abhay2004-rgb/class-D-3255/README.md

# class-D-3255
High-performance Class-D audio amplifier project based on the TPA3255 IC, designed for efficient power amplification, high-quality sound reproduction, and low distortion. This project explores audio electronics, amplifier integration, and DIY speaker system development.
