abhay2004-rgb/class-D-3255/board_preview.png

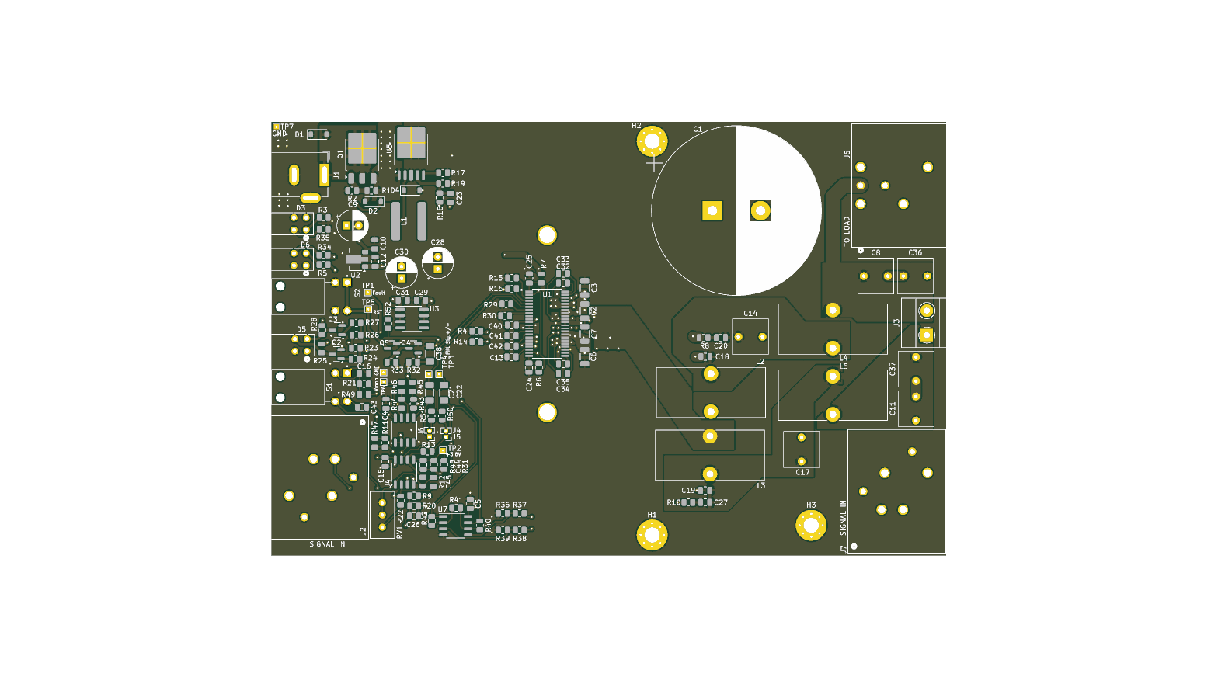
board_preview.png
