abhay2004-rgb/class-D-3255/TPA3255PBTL.kicad_pcb

## KiCad design TPA3255PBTL.kicad_pcb (2026-10-17)

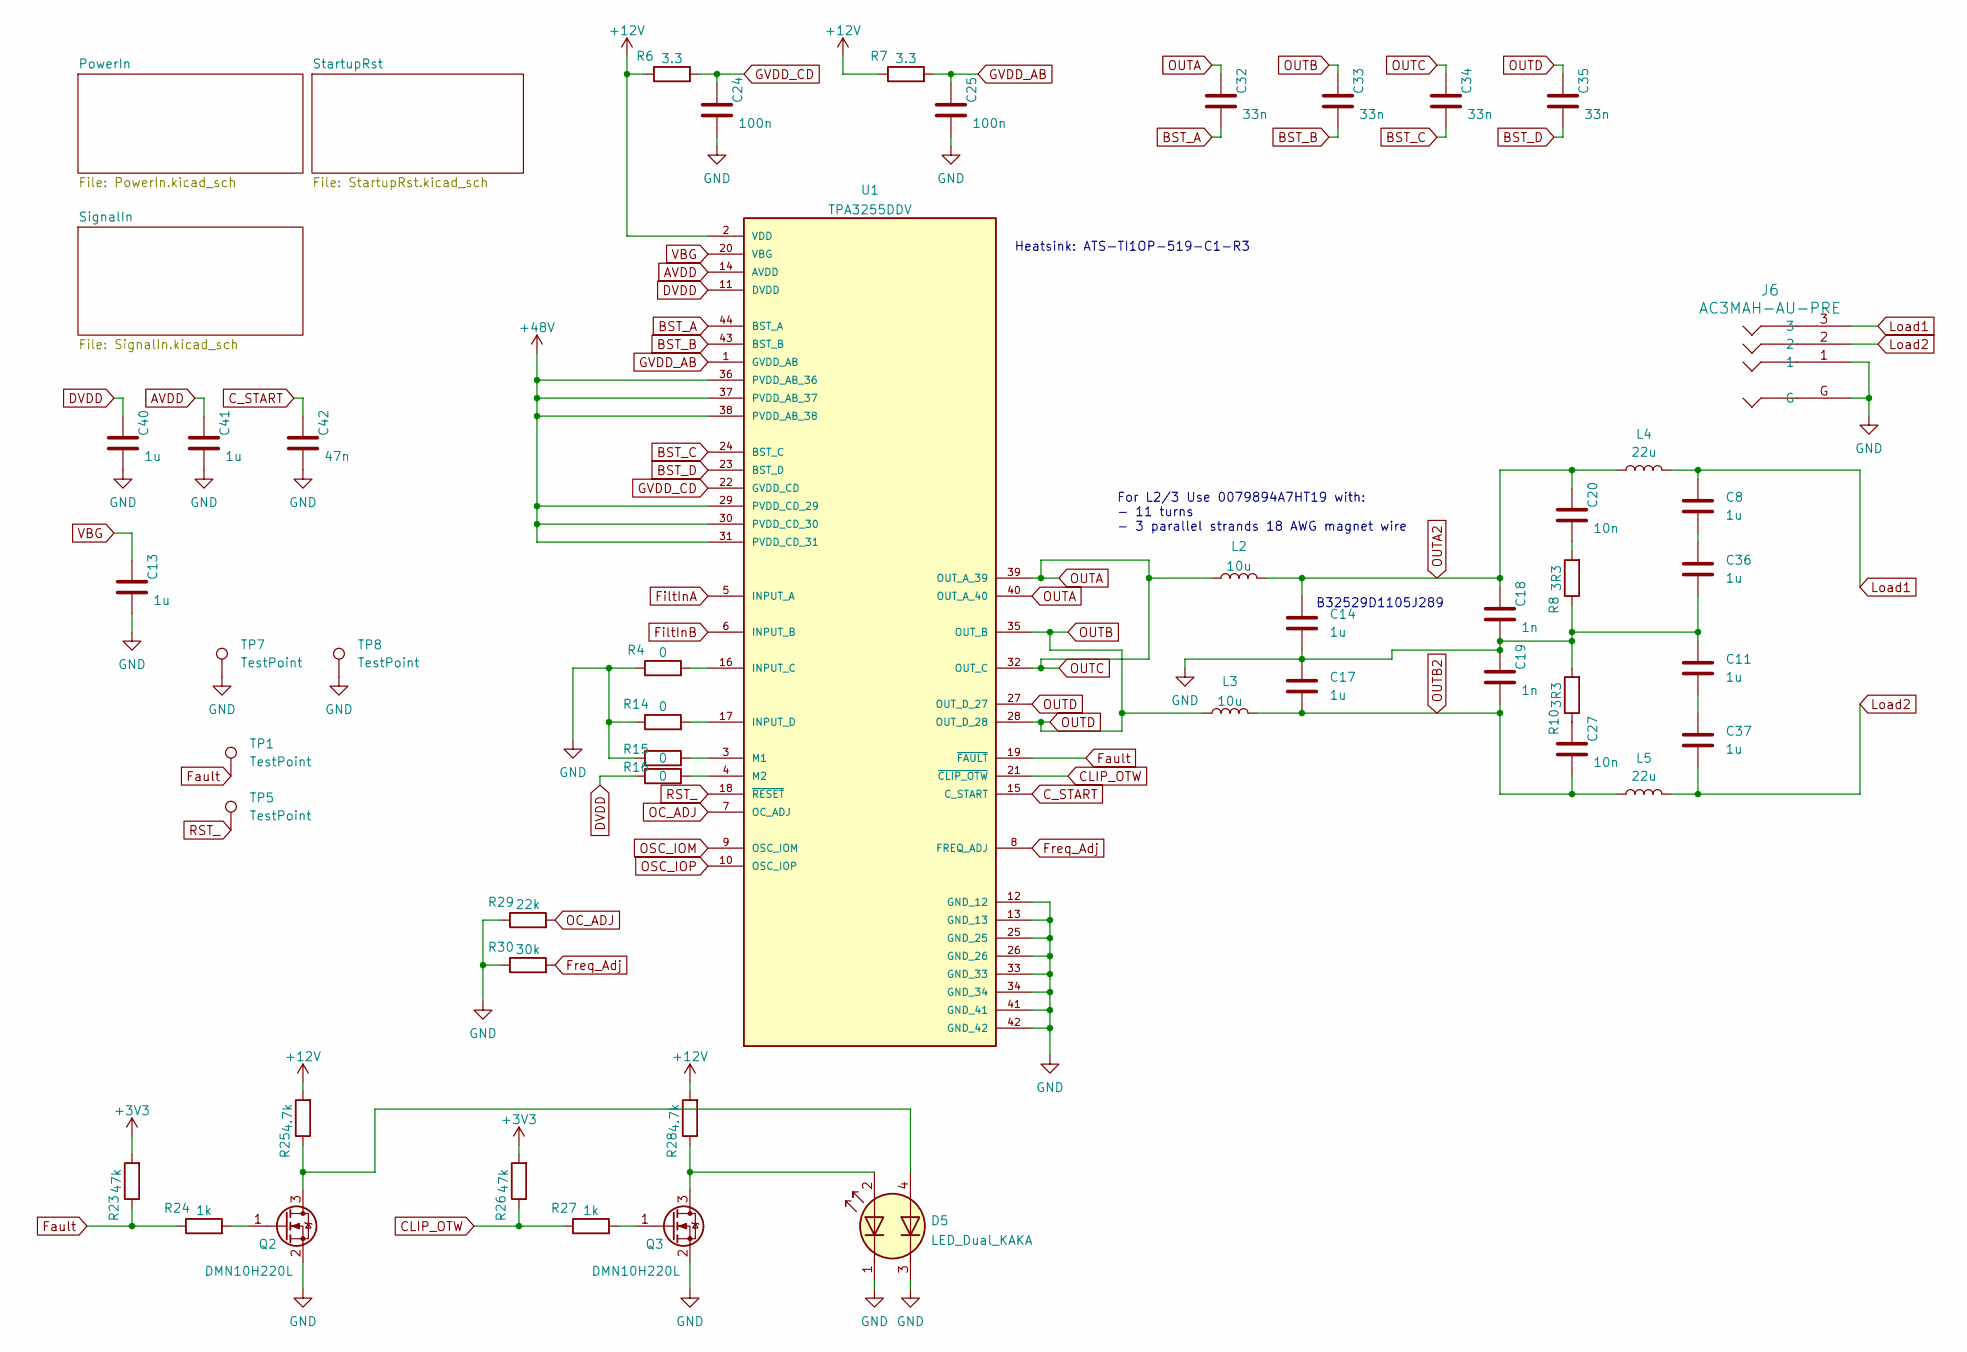
[picture p2: schematic TPA3255PBTL.kicad_sch]

Parts:
C8, C11, C14, C17, C36, C37: 1u; C_Rect_L7.2mm_W7.2mm_P5.00mm_FKS2_FKP2_MKS2_MKP2
C13, C40, C41: 1u; C_0805_2012Metric
C18, C19: 1n; C_0805_2012Metric
C20, C27: 10n; C_0805_2012Metric
C24, C25: 100n; C_0805_2012Metric
C32, C33, C34, C35: 33n; C_0805_2012Metric
C42: 47n; C_0805_2012Metric
D5: LED_Dual_KAKA; IC4_WP934EB_2GD_KNB
J6: AC3MAH-AU-PRE; AC3MAH-AU-PRE_AMP
L2, L3: 10u; L_Toroid_Vertical_L22.4mm_W10.2mm_P7.90mm_Vishay_TJ4
L4, L5: 22u; L_Toroid_Vertical_L22.4mm_W10.2mm_P7.90mm_Vishay_TJ4
Q2, Q3: DMN10H220L; SOT-23
R4, R14, R15, R16: 0; R_0805_2012Metric
R6, R7: 3.3; R_0805_2012Metric
R8, R10: 3R3; R_0805_2012Metric
R23, R26: 47k; R_0805_2012Metric
R24, R27: 1k; R_0805_2012Metric
R25, R28: 4.7k; R_0805_2012Metric
R29: 22k; R_0805_2012Metric
R30: 30k; R_0805_2012Metric
TP1, TP5, TP7, TP8: TestPoint; TestPoint_THTPad_1.0x1.0mm_Drill0.5mm
U1: TPA3255DDV; SOP63P810X120-44N; PARTREV A

Connections:
+3V3: R23.2, R26.2; also elsewhere on the board
+12V: R6.1, R7.1, R25.2, R28.2, U1.2 (VDD); also elsewhere on the board
+48V: U1.29 (PVDD_CD_29), U1.30 (PVDD_CD_30), U1.31 (PVDD_CD_31), U1.36 (PVDD_AB_36), U1.37 (PVDD_AB_37), U1.38 (PVDD_AB_38); also elsewhere on the board
AVDD: C41.1, U1.14 (AVDD)
BST_A: C32.2, U1.44 (BST_A)
BST_B: C33.2, U1.43 (BST_B)
BST_C: C34.2, U1.24 (BST_C)
BST_D: C35.2, U1.23 (BST_D)
CLIP_OTW: R26.1, R27.1, U1.21 (~CLIP_OTW)
C_START: C42.1, U1.15 (C_START)
DVDD: C40.1, R16.1, U1.11 (DVDD)
Fault: R23.1, R24.1, TP1.1, U1.19 (~FAULT)
FiltInA: U1.5 (INPUT_A); also elsewhere on the board
FiltInB: U1.6 (INPUT_B); also elsewhere on the board
Freq_Adj: R30.2, U1.8 (FREQ_ADJ)
GND: C11.1, C13.2, C14.2, C17.1, C18.2, C19.1, C24.2, C25.2, C36.2, C40.2, C41.2, C42.2, D5.1 (A1), D5.3 (A2), J6.1, J6.G, Q2.2 (S), Q3.2 (S), R4.1, R8.1, R10.2, R14.1, R15.1, R29.1, R30.1, TP7.1, TP8.1, U1.12 (GND_12), U1.13 (GND_13), U1.25 (GND_25), U1.26 (GND_26), U1.33 (GND_33), U1.34 (GND_34), U1.41 (GND_41), U1.42 (GND_42); also elsewhere on the board
GVDD_AB: C25.1, R7.2, U1.1 (GVDD_AB)
GVDD_CD: C24.1, R6.2, U1.22 (GVDD_CD)
Load1: C8.1, J6.3, L4.2; also elsewhere on the board
Load2: C37.2, J6.2, L5.2; also elsewhere on the board
unnamed: C11.2, C37.1
unnamed: C20.2, R8.2
unnamed: C27.1, R10.1
unnamed: C8.2, C36.1
unnamed: D5.2 (K1), Q3.3 (D), R28.1
unnamed: D5.4 (K2), Q2.3 (D), R25.1
unnamed: Q2.1 (G), R24.2
unnamed: Q3.1 (G), R27.2
unnamed: R4.2, U1.16 (INPUT_C)
unnamed: R14.2, U1.17 (INPUT_D)
unnamed: R15.2, U1.3 (M1)
unnamed: R16.2, U1.4 (M2)
OC_ADJ: R29.2, U1.7 (OC_ADJ)
OSC_IOM: U1.9 (OSC_IOM)
OSC_IOP: U1.10 (OSC_IOP)
OUTA: C32.1, C34.1, L2.1, U1.32 (OUT_C), U1.39 (OUT_A_39), U1.40 (OUT_A_40)
OUTA2: C14.1, C18.1, C20.1, L2.2, L4.1
OUTB: C33.1, C35.1, L3.1, U1.27 (OUT_D_27), U1.28 (OUT_D_28), U1.35 (OUT_B)
OUTB2: C17.2, C19.2, C27.2, L3.2, L5.1
RST_: TP5.1, U1.18 (~RESET); also elsewhere on the board
VBG: C13.1, U1.20 (VBG)

Notes on the sheet:
B32529D1105J289
For L2/3 Use 0079894A7HT19 with: - 11 turns - 3 parallel strands 18 AWG magnet wire
Heatsink: ATS-TI1OP-519-C1-R3

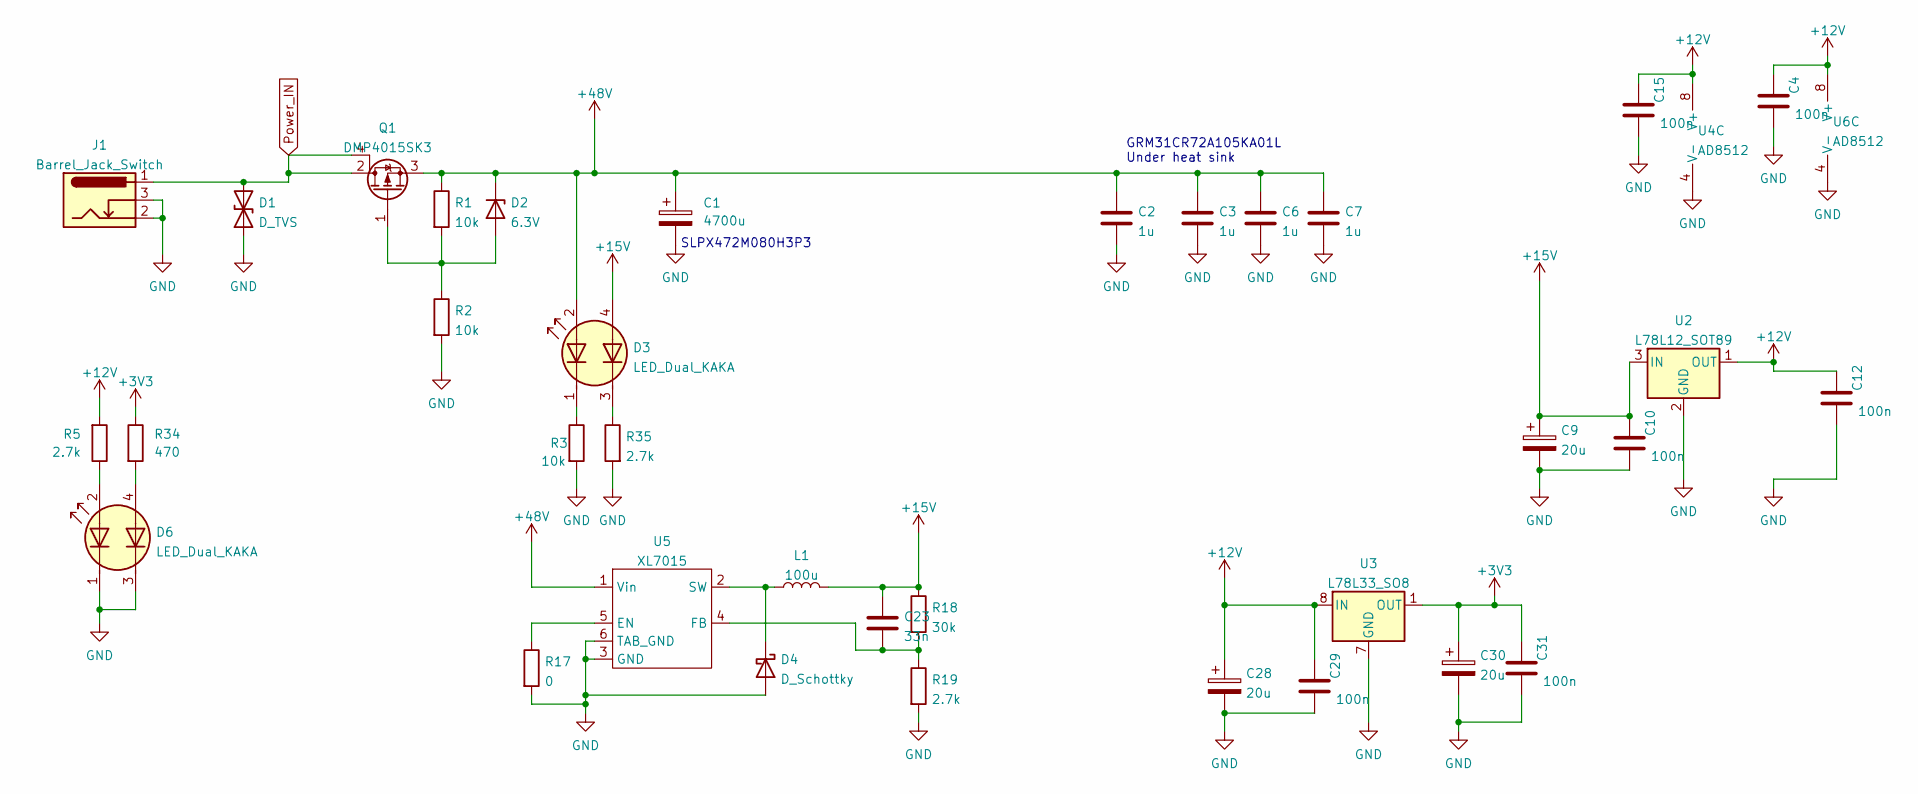
[picture p3: schematic PowerIn.kicad_sch]

Parts:
C1: 4700u; CP_Radial_D35.0mm_P10.00mm_SnapIn
C2, C3, C6, C7: 1u; C_1206_3216Metric
C4, C10, C12, C15, C29, C31: 100n; C_0805_2012Metric
C9, C28, C30: 20u; CP_Radial_D6.3mm_P2.50mm
C23: 33n; C_0805_2012Metric
D1: D_TVS; D_SOD-123
D2: 6.3V; D_SOD-123
D3, D6: LED_Dual_KAKA; IC4_WP934EB_2GD_KNB
D4: D_Schottky; D_SOD-123
J1: Barrel_Jack_Switch; BarrelJack_GCT_DCJ200-10-A_Horizontal
L1: 100u; MWPY8040; LCSC C501759
Q1: DMP4015SK3; TO-252-3_TabPin4
R1, R2, R3: 10k; R_0805_2012Metric
R5, R19, R35: 2.7k; R_0805_2012Metric
R17: 0; R_0805_2012Metric
R18: 30k; R_0805_2012Metric
R34: 470; R_0805_2012Metric
U2: L78L12_SOT89; SOT-89-3
U3: L78L33_SO8; SOIC-8_3.9x4.9mm_P1.27mm
U4, U6: AD8512; SO-8_3.9x4.9mm_P1.27mm
U5: XL7015; XL7015E1

Connections:
+3V3: C30.1, C31.1, R34.1, U3.1 (OUT); also elsewhere on the board
+12V: C4.1, C12.1, C15.1, C28.1, C29.1, R5.2, U2.1 (OUT), U3.8 (IN), U4.8 (V+), U6.8 (V+); also elsewhere on the board
+15V: C9.1, C10.1, C23.1, D3.4 (K2), L1.2, R18.1, U2.3 (IN)
+48V: C1.1, C2.1, C3.1, C6.1, C7.1, D2.1 (K), D3.2 (K1), Q1.3 (S), R1.1, U5.1 (Vin); also elsewhere on the board
GND: C1.2, C2.2, C3.2, C4.2, C6.2, C7.2, C9.2, C10.2, C12.2, C15.2, C28.2, C29.2, C30.2, C31.2, D1.1 (A1), D4.2 (A), D6.1 (A1), D6.3 (A2), J1.2, J1.3, R2.2, R3.2, R17.2, R19.2, R35.2, U2.2 (GND), U3.2 (GND), U3.3 (GND), U3.6 (GND), U3.7 (GND), U4.4 (V-), U5.3 (GND), U5.6 (TAB_GND), U6.4 (V-); also elsewhere on the board
unnamed: D2.2 (A), Q1.1 (G), R1.2, R2.1
unnamed: D3.1 (A1), R3.1
unnamed: D3.3 (A2), R35.1
unnamed: D4.1 (K), L1.1, U5.2 (SW)
unnamed: D6.2 (K1), R5.1
unnamed: D6.4 (K2), R34.2
unnamed: R17.1, U5.5 (EN)
unnamed: C23.2, R18.2, R19.1, U5.4 (FB)
Power_IN: D1.2 (A2), J1.1, Q1.2 (D), Q1.4 (D)

Notes on the sheet:
GRM31CR72A105KA01L Under heat sink
SLPX472M080H3P3

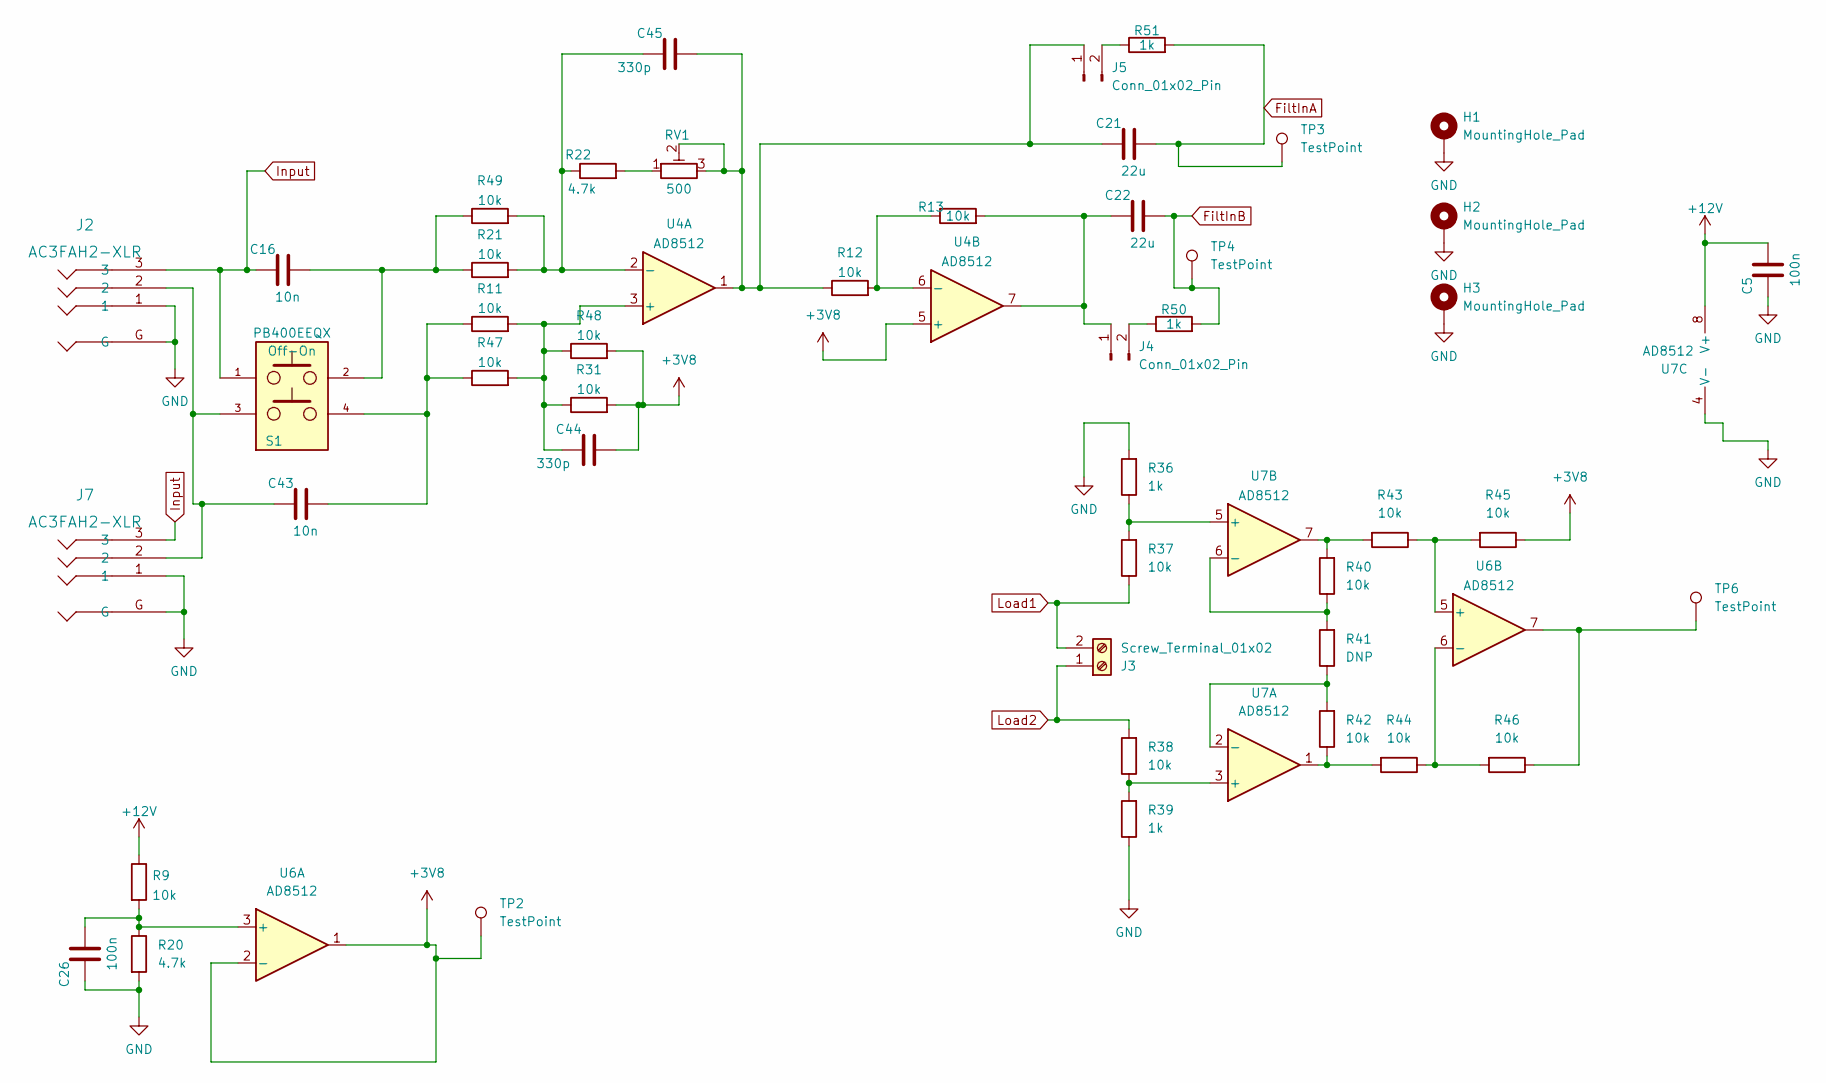
[picture p4: schematic SignalIn.kicad_sch]

Parts:
C5, C26: 100n; C_0805_2012Metric
C16, C43: 10n; C_0805_2012Metric
C21, C22: 22u; C_1206_3216Metric_Pad1.33x1.80mm_HandSolder
C44, C45: 330p; C_0805_2012Metric
H1, H2, H3: MountingHole_Pad; MountingHole_3.2mm_M3_Pad_Via
J2, J7: AC3FAH2-XLR; AC3FAH2-F-XLR
J3: Screw_Terminal_01x02; TerminalBlock_Phoenix_MKDS-1,5-2-5.08_1x02_P5.08mm_Horizont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
J4, J5: Conn_01x02_Pin; PinHeader_1x02_P1.27mm_Vertical
R9, R11, R12, R13, R21, R31, R37, R38, R40, R42, R43, R44, R45, R46, R47, R48, R49: 10k; R_0805_2012Metric
R20, R22: 4.7k; R_0805_2012Metric
R36, R39, R50, R51: 1k; R_0805_2012Metric
R41: DNP; R_0805_2012Metric
RV1: 500; Potentiometer_Bourns_3296W_Vertical
S1: PB400EEQX; SW_PB400EEQX; PARTREV NA
TP2, TP3, TP4, TP6: TestPoint; TestPoint_THTPad_1.0x1.0mm_Drill0.5mm
U4, U6, U7: AD8512; SO-8_3.9x4.9mm_P1.27mm

Connections:
+3V8: C44.2, R31.2, R45.1, R48.2, TP2.1, U4.5 (+), U6.1, U6.2 (-)
+12V: C5.2, R9.1, U7.8 (V+); also elsewhere on the board
FiltInA: C21.2, R51.2, TP3.1; also elsewhere on the board
FiltInB: C22.2, R50.2, TP4.1; also elsewhere on the board
GND: C5.1, C26.1, H1.1, H2.1, H3.1, J2.1, J2.G, J7.1, J7.G, R20.2, R36.2, R39.1, U7.4 (V-); also elsewhere on the board
Input: C16.1, J2.3, J7.3, S1.1
Load1: J3.2, R37.1; also elsewhere on the board
Load2: J3.1, R38.2; also elsewhere on the board
unnamed: C16.2, R21.1, R49.1, S1.2
unnamed: C43.1, J2.2, J7.2, S1.3
unnamed: C43.2, R11.1, R47.1, S1.4
unnamed: C22.1, J4.1, R13.2, U4.7
unnamed: J4.2, R50.1
unnamed: C21.1, C45.2, J5.1, R12.1, RV1.2, RV1.3, U4.1
unnamed: J5.2, R51.1
unnamed: R22.2, RV1.1
unnamed: R40.2, R43.2, U7.7
unnamed: R42.1, R44.2, U7.1
unnamed: R46.1, TP6.1, U6.7
unnamed: C44.1, R11.2, R31.1, R47.2, R48.1, U4.3 (+)
unnamed: C45.1, R21.2, R22.1, R49.2, U4.2 (-)
unnamed: R12.2, R13.1, U4.6 (-)
unnamed: C26.2, R9.2, R20.1, U6.3 (+)
unnamed: R43.1, R45.2, U6.5 (+)
unnamed: R44.1, R46.2, U6.6 (-)
unnamed: R38.1, R39.2, U7.3 (+)
unnamed: R41.1, R42.2, U7.2 (-)
unnamed: R36.1, R37.2, U7.5 (+)
unnamed: R40.1, R41.2, U7.6 (-)

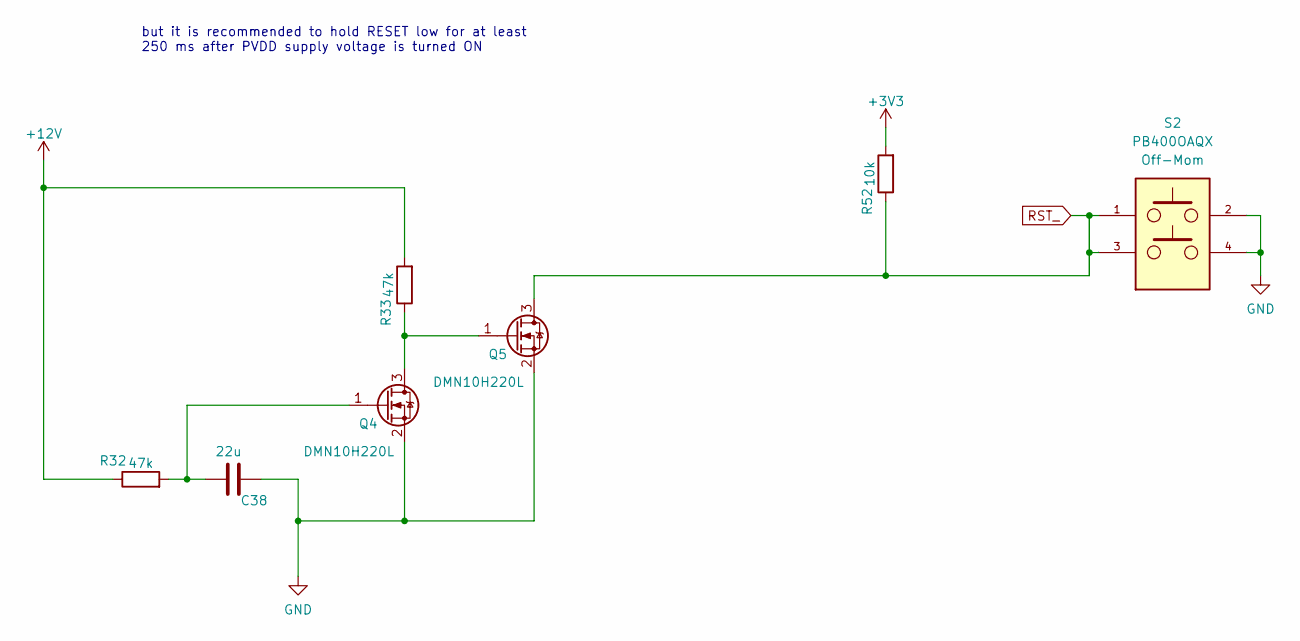
[picture p5: schematic StartupRst.kicad_sch]

Parts:
C38: 22u; C_1206_3216Metric_Pad1.33x1.80mm_HandSolder
Q4, Q5: DMN10H220L; SOT-23
R32, R33: 47k; R_0805_2012Metric
R52: 10k; R_0805_2012Metric
S2: PB400OAQX; SW_PB400EEQX; PARTREV NA

Connections:
+3V3: R52.2; also elsewhere on the board
+12V: R32.1, R33.2; also elsewhere on the board
GND: C38.1, Q4.2 (S), Q5.2 (S), S2.2, S2.4; also elsewhere on the board
unnamed: Q4.3 (D), Q5.1 (G), R33.1
unnamed: C38.2, Q4.1 (G), R32.2
RST_: Q5.3 (D), R52.1, S2.1, S2.3; also elsewhere on the board

Notes on the sheet:
but it is recommended to hold RESET low for at least 250 ms after PVDD supply voltage is turned ON

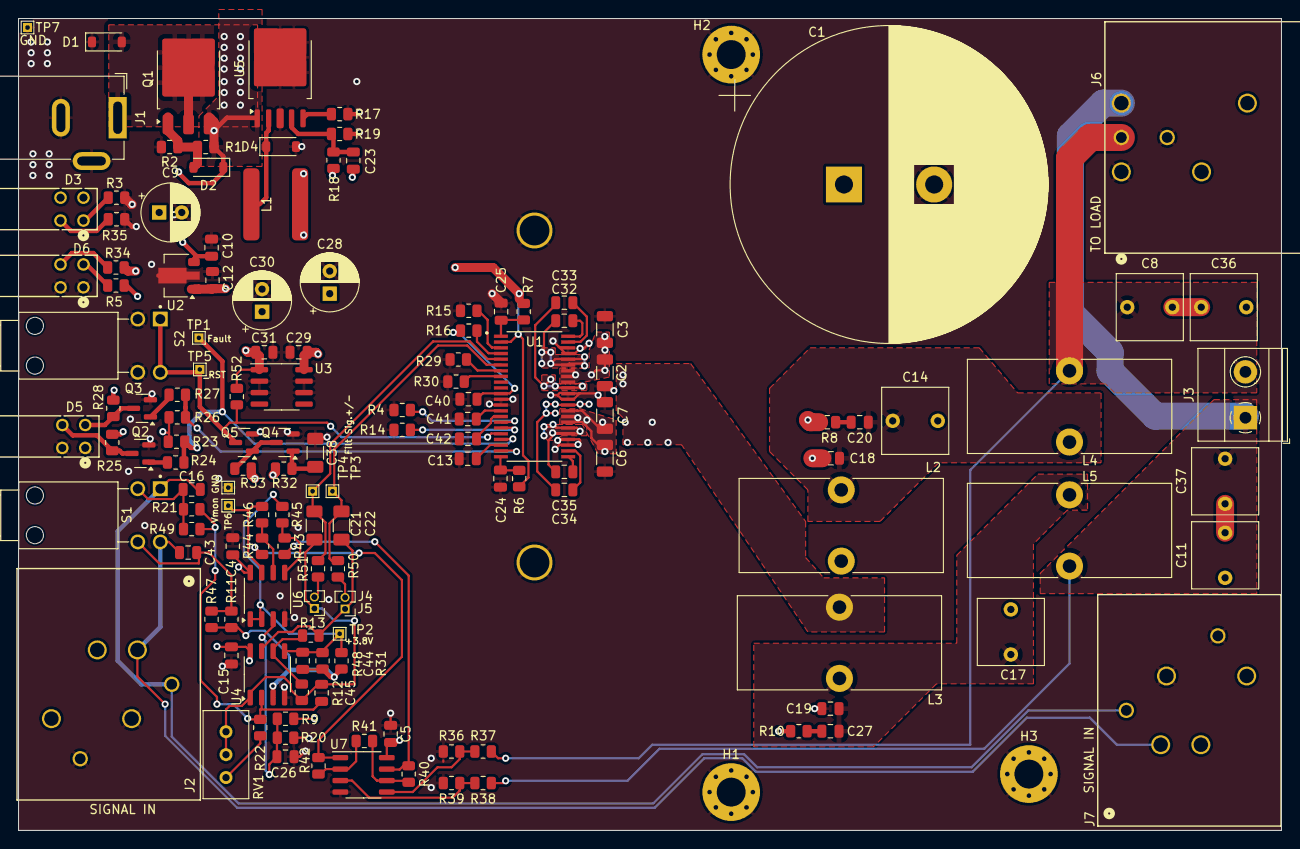
[picture p6: board TPA3255PBTL.kicad_pcb from above]

Board: 4 copper layers, 140.0 x 90.0 mm, 140 parts (0 on the bottom side), 74 nets.
